ElecGeek/PulsesGene/(list of files, drawings)

Other design files:
pulses_gene.pcb
