ElecGeek/PulsesGene/(threads)

Thread 1 (2023-08-08):

Minor or major bug in the +1, 0 or -1 amplifier

ElecGeek, 2023-08-08:
Pulses are physically generated by a +1,0 or -1 amplifier. Two analogue switches (X8) closes to get the +1 and the -1.
Two slots of an integrated circuit 74HC4066 are used.
This circuit does not have a negative power supply (as the 74HC4051, 52 and 53). Then they don't have the expected behaviour when the voltage is close to 0.
* For SMD PCB, it is a major bug as no work around is possible but the rest of the project can be tested.
* For through hole PCB, it is a minor bug as a daughter board can convert to a 74HC4051, 52 or 53. An additional pin is necessary to connect the negative supply somewhere in the circuit.

ElecGeek, 2023-09-02:
The commit of the 31 august fixes the schematic. A PCB can be drawn.
TODO update all the simulation stuff.

ElecGeek, 2024-02-12:
Fixed and tested using a real PCB

Closed 2024-02-12.
