ElecGeek/PulsesGene/(commit log)

2023-05-09 Initial version
    [AMP_OP.sch, HC4066.sch, pulses_gene_analog.sch, pulses_gene_analog_test.sch, pulses_gene_numeric.sch, pulses_gene_power.sch]
2023-06-24 Initial version of the new pulses generator
    It is now based on logic rather than monostables
    The pulse width is now adjustable and controlled by the clock frequency
    [pulses_gene_numeric.sch]
2023-06-24 Tests and fixes
    New VHDL test file
    Fixes in the HC163 model
    [Models_74HC.vhdl, pulses_gene_numeric_test.vhdl]
2023-06-24 Add the clock oscillator
    [pulses_gene_numeric.sch]
2023-06-25 Some cleanup
    More information has been added in the README
    Private symbols (for the OP AMPs) was missing. That produced schematics exports in PS or PDF with red error text.
    Partslists has been improved.
    The 'net=' has been removed for the input and outputs in the analogue file.
    [pulses_gene_analog.sch, pulses_gene_numeric.sch]
2023-07-25 Build improvement
    spice_fix.sed renamed into spice_fix.reg
    net_pcb_fix.reg introduced because (at least my version) does not
    properly support the slots (more than 1 circuit in a package) in exports
    The work around is to name e.g. X10_1 and X10_2. The slots name properly the pins
    but PCB sees 2 circuits. A fix removes the _1 and _2
    vhdl_fix.reg introduced because not all vhdl compilers supports
    net names as a full numeric name. The port maps are updated
    to add a P before the component net names.
    [pulses_gene_power.sch]
2023-09-01 Major bug fix and improvements
    * 4066 replaced by 4053 to run from V+ to V- (rather than V+ to 0)
    * --> However the new schematic has not (yet) been simulated,
    nor the spice model has not (yet) been updated.
    The analogue simulation probably crashes.
    * More work on the power schematics and on the components data
    * PCB mostly done and topview exported
    [pulses_gene.pcb, pulses_gene_analog.sch, pulses_gene_numeric.sch, pulses_gene_power.sch]
2023-09-02 Minor fixes
    BAT54 SOT symbols was missing
    Most of the 74HC had incorrect footprint, DIL14 rather than SOIC14
    C7 is now unpolarized MLCC 1206 capa
    Makefile (and then the worflow) now exports the power schema page into PS and PDF
    [pulses_gene_analog.sch, pulses_gene_numeric.sch]
2023-09-13 BUG fix
    The model of the HC4066 has been replaced by HC4053
    simulation still has to be done
    The input circuit was completely wrong
    100% fixed
    [HC4053.sch, HC4066.sch, pulses_gene_analog.sch, pulses_gene_analog_test.sch]
2023-09-26 Operational amplifiers improvement
    Now, there are 2 models
    * the "normal" one for the signal part, e.g. TLV07IDR @+-35 euro cents
    * the fast one for the pulses, e.g. OPA196IDR @ +-1.26 euros
    [AMP_OP_FAST.sch, pulses_gene_analog.sch, pulses_gene_analog_test.sch]
2023-09-29 Some minor fix
    [pulses_gene.pcb, pulses_gene_analog.sch, pulses_gene_numeric.sch, pulses_gene_power.sch]
2023-10-20 Component attributes fixes
    [pulses_gene.pcb, pulses_gene_analog.sch, pulses_gene_numeric.sch, pulses_gene_power.sch]
2023-10-20 pulses_separ
    Please note this is due to some requests.
    It is not going to be supported.
    [pulses_gene.pcb, pulses_gene_numeric.sch]
2023-10-21 Fix the slot mistake in the symbol
2023-10-21 (fix the 4053 symbol) ... and fis the PCB as well
    [pulses_gene.pcb]
2023-10-31 Replace the CONN6 by an output component
    For a usage with another schematics, the explicit output connector is irrelevant.
    For a stand alone usage, a small sheet should contain an input component
    and the connector one wants.
    [pulses_gene_analog.sch]
2023-11-26 Some values change
    R50 decreased to 4.75K to fit a lower charge impedance, down to 322ohms.
    R31, R32, R33 decreased to 6.19K to increase the light.
    R9 decreased to 3.90K and the level has been definitively fixed.
    X1 output is 0dB 1mW/600ohms.
    Then the max is 1.095V
    Then the output of X1 is 5.981V
    R1 and R2 has to be adjusted to fit the input level
    [pulses_gene_analog.sch]
2024-01-03 Some updates
    * The operational amplifiers had their values updated for more realistic behavior
    * One decoupling capacitor increased from 22nF to 220nF
    * vhdl_fix.reg updated to fix the line "architecture netlist of Pulses_gene is" rather than "not found"
    [AMP_OP.sch, AMP_OP_FAST.sch, pulses_gene_power.sch]
2024-01-13 Improve the automated workflow
    The numerical schematic has been purged from the non numerical component
    which has been moved into the pulses_gene_power.sch file.
    More sed fixes some incompatibilities of the schematic export into VHDL.
    Makefile entries run the simulation and the synthesis using an ice40 lp384 QFN32 package.
    TOTO: write from scratch a RTL behavior VHDL file rather than to synthesise from the schematic.
    [pulses_gene_numeric.sch, pulses_gene_power.sch]
2024-01-13 Move the saturation to +-6V rather than 5V
    [AMP_OP.sch, AMP_OP_FAST.sch]
2024-01-13 Fix schematic export bug
    The version available by apt-get of Lepton EDA
    forgets to declare the signals of NC (not connected) pins.
    Perhaps, they plan to call sub circuits, using "open".
    The work around is to force their name.
    However, some additional work is needed to make the syntheses up and running
    as I have to compile, in the workflow, the ghdl-yosys plug-in
    [pulses_gene_numeric.sch]
2025-04-13 Fix a FATAL bug
    The NJW4191 can accept large power supply voltage.
    However the ON/OFF voltage should not exceed 6V.
    The new parts-list and schematic diagrams are going to be produced by the artifact.
    Since this project is a fun demo project,
    Since the charge pump has not been placed nor routed on the PCB,
    The PCB is not going to be updated.
    [pulses_gene_power.sch]
2026-01-29 Gerber export forgotten from the beginning.
    This is a FUN PCB to show the dimensions of the schematic diagrams.
    The ground and power planes has not been converted into polygons.
    I generally draw planes using fat lines to make the modifications more easy at the early stages.
    It is not a problem as the analogue part frequency is about a couple of kilo Hz
    and the digital part frequency is about a couple of hundreds of kilo Hz.
    However, the loops has been minimized. A trace of plus and a trace of minus have been drawn
    between two circuits each time a signal connects these two circuits.
    [PCB_CB.bottom.gbr, PCB_CB.bottommask.gbr, PCB_CB.bottompaste.gbr, PCB_CB.bottomsilk.gbr, PCB_CB.fab.gbr, PCB_CB.group9.gbr, PCB_CB.mechanical.gbr, PCB_CB.top.gbr]
